Sergiobridie/Bluetooth-robot/B.O.M/B.O.M.xlsx

Sheet: B.O.M
ARDUNIO BLUETOOTH ROBOT
BILL OF MATERIRALS
DEPARTMENTS
Electric & Electronic
Parts | MEDIA (https://github.com/Sergiobridie/Bluetooth-robot/tree/master/MEDIA)
Software
User maual (https://github.com/Sergiobridie/Bluetooth-robot/blob/master/User%20manual/User%20manual.docx)

Sheet: E&E
start | ELECTRIC & ELECTRONIC
 | Name | Units | Price | URL | Photo
 | ARDUINO UNO REV3 | 1 | 20 € | arduino.cc (https://store.arduino.cc/arduino-uno-rev3)
 | PROTO SHIELD REV3 (UNO SIZE) | 1 | 6.90 € | arduino.cc (https://store.arduino.cc/proto-shield-rev3-uno-size)
 | BLUETOOTH (HC-05) | 1 | 3.99 € | ebay (http://www.ebay.es/itm/Modulo-inalambrico-Arduino-HC-06-HC06-Bluetooth-con-base-Slave-W0009/201955035393)
 | INTEGRATED CHIP (L293D) | 1 | 1.79 € | ebay (http://www.ebay.es/itm/2x-L293D-CONTROLADOR-MOTOR-PASO-A-PASO-CONTINUA-0-6A-HALF-H-DRIVER-ARDUINO-T045/202098803976)
 | ARDUINO BUZZER | 1 | 1.05 € | ebay (http://www.ebay.es/itm/3-x-Zumbador-Buzzer-pasivo-3-a-12Vdc-Electronica-arduino-prototipos-/261570489429)
 | ALIMENTATION JACK | 1 | 1.95 € | ebay (http://www.ebay.es/itm/Conector-alimentacion-DC-Jack-5-5mm-x-2-1mm-carcasa-aereo-MACHO-9mm-Lote-5-u/322850517789)
 | LIPO BATTERY (850mAh 2S 25C) | 1 | 5.18 € | hobbyking (https://hobbyking.com/en_us/zippy-compact-850mah-2s-25c-lipo-pack.html)
 | FEMALE JST | 1 | 1.90 € | hobbyking (https://hobbyking.com/en_us/female-jst-battery-pigtail-10cm-length-10pcs-bag.html)
 | SWITCH | 1 | 1.03 € | aliexpress (https://es.aliexpress.com/store/product/Genuine-JOYING-LIANG-SS-12F30-Black-Small-Toggle-Switch-Toy-DIY-Switches/404012_32821875633.html)
 | WIRE | 1 | 2.90 € | amazon (https://www.amazon.es/gp/product/B00K67XXSI/ref=oh_aui_detailpage_o01_s00?ie=UTF8&psc=1)
 | ADHESIVE VELCRO | 1 | 2.77 € | aliexpress (https://es.aliexpress.com/store/product/2-Rolls-100mm-1m-Black-Hook-and-Loop-Self-Adhesive-Fastener-Strong-Tape-Hook-and-Loop/822826_32811494169.html)
 | SCREW 3X15 | 2
 | SCREW 3X5 | 4
 | CLAMP | 1
 | DC MOTORS ARDUINO 6V 600RPM | 2 | 2.21 € | aliexpress (https://es.aliexpress.com/item/1pc-N20-30-600-1000-1200RPM-DC-3-6-12V-Micro-Deceleration-Gear-Reducer-Motor-Small/32817260252.html)

Sheet: Parts
start | PARTS
 | Name | Units | URL | Photo
 | Base and back | 1 | STL (https://github.com/Sergiobridie/Bluetooth-robot/blob/master/3D%20Pieces/stl/Base%20and%20back.stl)
 |  |  | freecad (https://github.com/Sergiobridie/Bluetooth-robot/blob/master/3D%20Pieces/freecad/Base%20and%20back.FCStd)
 | Pololu wheel | 2 | STL (https://github.com/Sergiobridie/Bluetooth-robot/blob/master/3D%20Pieces/stl/Pololu%20wheel.stl)
 |  |  | freecad (https://github.com/Sergiobridie/Bluetooth-robot/blob/master/3D%20Pieces/freecad/Pololu%20wheel.FCStd)
 | Front side | 1 | STL (https://github.com/Sergiobridie/Bluetooth-robot/blob/master/3D%20Pieces/stl/Front%20side.stl)
 |  |  | freecad (https://github.com/Sergiobridie/Bluetooth-robot/blob/master/3D%20Pieces/freecad/Front%20side.FCStd)
 | Motor bracket | 2 | STL (https://github.com/Sergiobridie/Bluetooth-robot/blob/master/3D%20Pieces/stl/Motor%20bracket.stl)
 | Ball caster | 1 | STL (https://github.com/Sergiobridie/Bluetooth-robot/blob/master/3D%20Pieces/stl/Ball%20caster.stl)
 | Tire wheel | 2 | ebay (https://www.ebay.es/itm/LEGO-Creativ-City-tecnico-4-unidades-Neumaticos-30-4-x-14-offset-mm-30391-NUEVO/132337132647)
 | Metal ball | 1

Sheet: Software
start | SOFTWARE
 | Arduino Program (https://github.com/Sergiobridie/Bluetooth-robot/blob/master/Software_bluetooth_robot/Software_bluetooth_robot.ino) | Android APP (https://play.google.com/store/apps/details?id=braulio.calle.bluetoothRCcontroller&hl=es)
 | Bluetooth configuration program (work in progres)
