Sergiobridie/Bluetooth-robot/3D Pieces/freecad/Base and back.FCStd

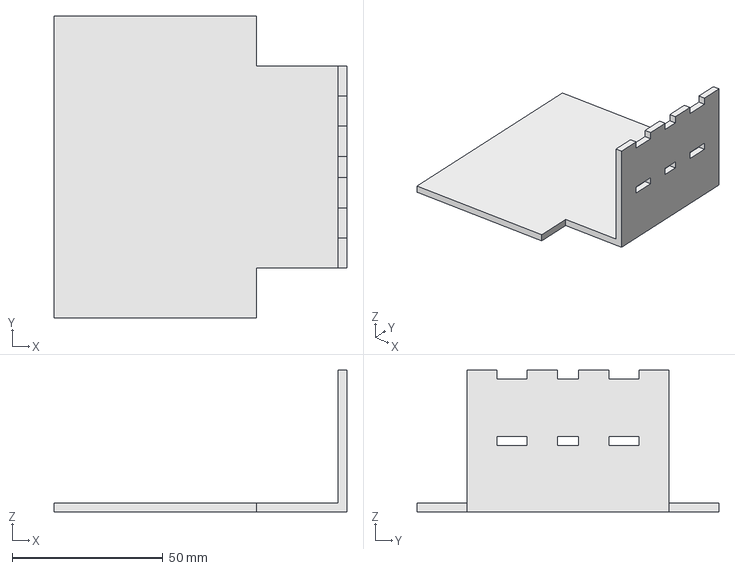
[picture p1: CAD file, 2018-02-22]
3D Pieces/freecad/Base and back.FCStd
97.0 x 100.0 x 47.0 mm
