Sergiobridie/Bluetooth-robot/3D Pieces/stl/Ball caster.stl

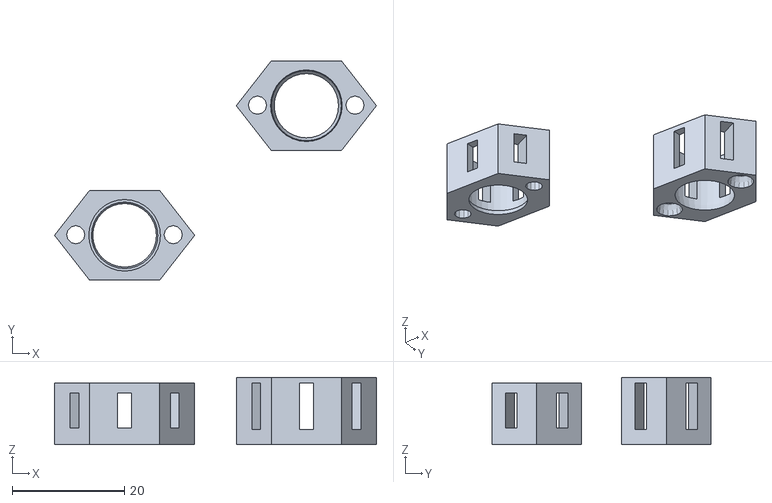
[picture p2: CAD file, 2018-02-22]
3D Pieces/stl/Ball caster.stl
57.4 x 39.1 x 12.0
