Sergiobridie/Bluetooth-robot/3D Pieces/freecad/Pololu wheel.FCStd

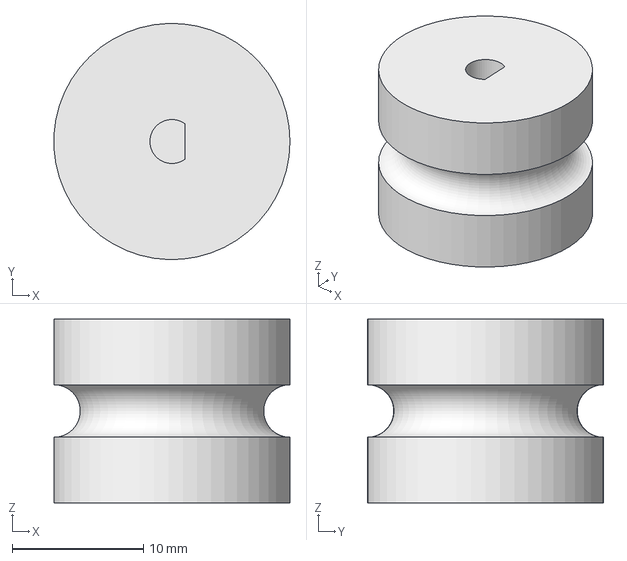
[picture p3: CAD file, 2018-02-22]
3D Pieces/freecad/Pololu wheel.FCStd
18.0 x 18.0 x 14.0 mm
