Sergiobridie/Bluetooth-robot/3D Pieces/stl/Motor bracket.stl

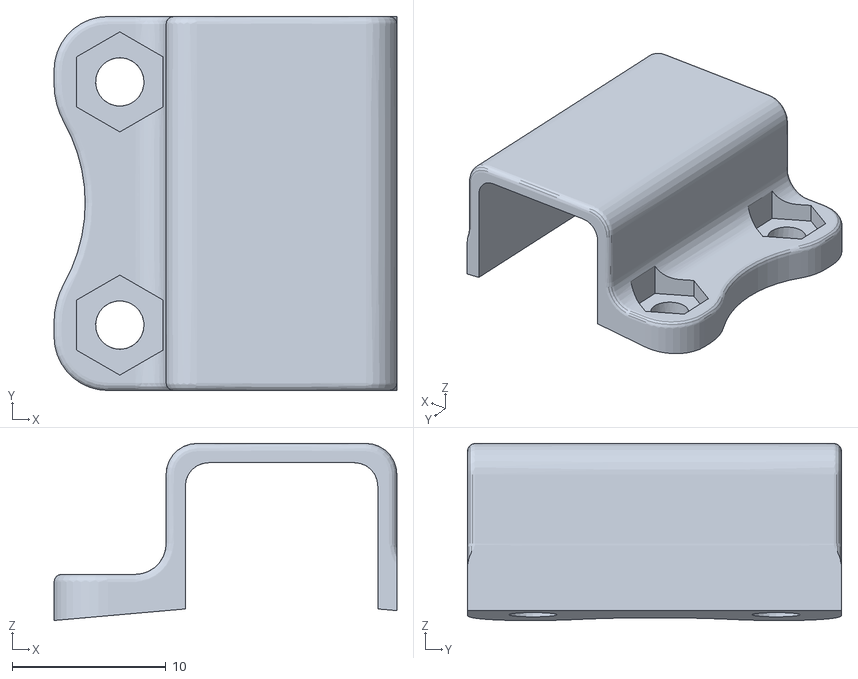
[picture p4: CAD file, 2018-02-22]
3D Pieces/stl/Motor bracket.stl
22.3 x 24.3 x 11.5
