Sergiobridie/Bluetooth-robot/3D Pieces/freecad/Front side.FCStd

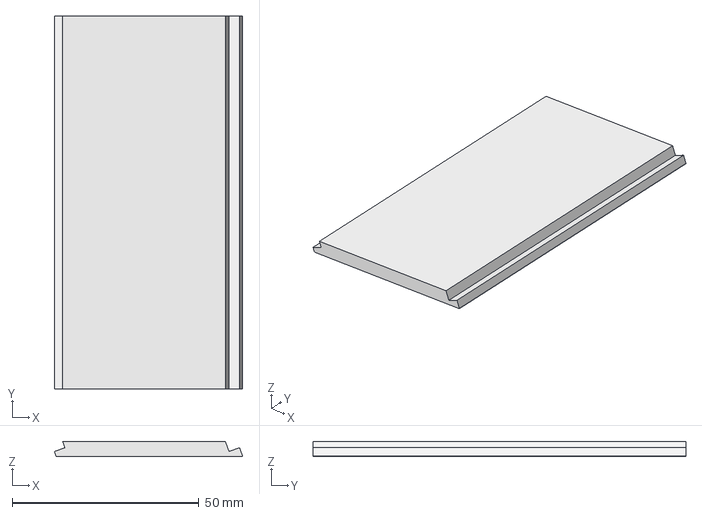
[picture p5: CAD file, 2018-02-22]
3D Pieces/freecad/Front side.FCStd
50.5 x 100.0 x 4.00 mm
