Sergiobridie/Bluetooth-robot/(list of files, cad)

Other CAD files:
3D Pieces/stl/Base and back.stl
3D Pieces/stl/Front side.stl
3D Pieces/stl/Pololu wheel.stl
